lisberg/cable_tester2/hardware/sim/report.md

# Channel cell simulation – Rs = 4700 Ω, Rbias = 680000 Ω

Generated by `hardware/sim/channel_sim.py` (ngspice). Worst‑case corners: Rs +1 %, Rbias −1 %, leakage 1 µA/node against the drive, mux Ron 20 Ω/stage, driver 50 Ω + Rlim 150 Ω, cable 500 pF + node 50 pF per member.

## 1. Static level on the weakest net member vs. net size

Pass criterion: ≥ 0.75·VDD (VIH(max) 0.70·VDD + 0.05·VDD margin). Typical 74HC switching point ≈ 0.5·VDD. Low polarity mirrors high polarity, so only high is shown.

| N members | VDD 4.40 V: V (ratio) | VDD 5.25 V: V (ratio) | worst case | typical (0.5·VDD) |
|---|---|---|---|---|
| 1 | 4.33 V (0.98) | 5.16 V (0.98) | PASS | PASS |
| 2 | 4.29 V (0.97) | 5.12 V (0.98) | PASS | PASS |
| 4 | 4.22 V (0.96) | 5.04 V (0.96) | PASS | PASS |
| 8 | 4.08 V (0.93) | 4.88 V (0.93) | PASS | PASS |
| 16 | 3.83 V (0.87) | 4.59 V (0.87) | PASS | PASS |
| 24 | 3.61 V (0.82) | 4.32 V (0.82) | PASS | PASS |
| 32 | 3.40 V (0.77) | 4.09 V (0.78) | PASS | PASS |
| 40 | 3.22 V (0.73) | 3.87 V (0.74) | fail | PASS |
| 48 | 3.05 V (0.69) | 3.67 V (0.70) | fail | PASS |
| 64 | 2.75 V (0.63) | 3.32 V (0.63) | fail | PASS |
| 96 | 2.28 V (0.52) | 2.77 V (0.53) | fail | fail |
| 128 | 1.92 V (0.44) | 2.36 V (0.45) | fail | fail |

**Guaranteed net size (worst case): ≥ 32 members. Typical: ≥ 64 members.**

## 2. Isolated node offset (leakage)

* VDD 4.4 V: isolated node sits at 0.687 V; VIL(min) = 0.30·VDD = 1.32 V → PASS (margin 0.63 V)
* VDD 5.25 V: isolated node sits at 0.687 V; VIL(min) = 0.30·VDD = 1.57 V → PASS (margin 0.89 V)

## 3. Settle time after the stimulus switches (5 m cable)

Time from drive edge until the weakest member crosses 0.75·VDD (VDD 4.4 V). Firmware settle time per step must exceed this. Releasing a net uses active discharge, which is the same RC path.

| N members | settle |
|---|---|
| 1 | 7.8 µs |
| 2 | 11.8 µs |
| 4 | 20.3 µs |
| 8 | 38.6 µs |
| 16 | 82.9 µs |
| 32 | 258.1 µs |
| 36 | 480.5 µs |

## 4. DC fault on a fixture node (powered, VDD5 held by the shunt clamp at 5.45 V)

| EXT | I(Rs) | P(Rs) | node voltage | share into IC ESD diodes |
|---|---|---|---|---|
| +24 V | 3.81 mA | 68 mW | 6.25 V | 3.67 mA |
| +30 V | 5.10 mA | 121 mW | 6.29 V | 4.77 mA |
| -24 V | -4.98 mA | 115 mW | -0.84 V | 4.67 mA |
| -30 V | -6.26 mA | 182 mW | -0.87 V | 5.64 mA |

Rs (1206, ≥ 0.25 W) covers the dissipation. A high‑Vf low‑leakage external clamp does **not** take the current away from the IC input diodes: most of it flows through the ICs. The bound is therefore Rs itself. Keep the per‑input injection below the IC absolute‑maximum clamp current (74HC: ±20 mA; TMUX1308: check datasheet), and make the VDD5 shunt clamp absorb the sum.

## 5. Sensitivity: Rs / Rbias / leakage

Guaranteed net size (worst case), isolated‑node offset at 4.4 V (limit 0.25·VDD = 1.10 V), and Rs dissipation at −30 V.

| Rs | Rbias | leakage/node | N guaranteed | V isolated | P(Rs) @ −30 V |
|---|---|---|---|---|---|
| 4.7 kΩ | 470 kΩ | 2 µA | 20 | 0.95 V | 182 mW |
| 4.7 kΩ | 470 kΩ | 0.5 µA | 28 | 0.24 V | 182 mW |
| 4.7 kΩ | 680 kΩ | 1 µA | 36 | 0.69 V | 182 mW ◀ chosen |
| 4.7 kΩ | 1000 kΩ | 0.5 µA | 56 | 0.51 V | 182 mW |
| 3.3 kΩ | 680 kΩ | 1 µA | 48 | 0.69 V | 259 mW ✗ |
| 3.3 kΩ | 1000 kΩ | 0.5 µA | 76 | 0.51 V | 259 mW ✗ |
| 2.2 kΩ | 1000 kΩ | 0.5 µA | 112 | 0.51 V | 387 mW ✗ |
