lisberg/cable_tester2/hardware/proto40/control.kicad_sch

## KiCad design hardware/proto40/control.kicad_sch (2026-10-07, an earlier design)

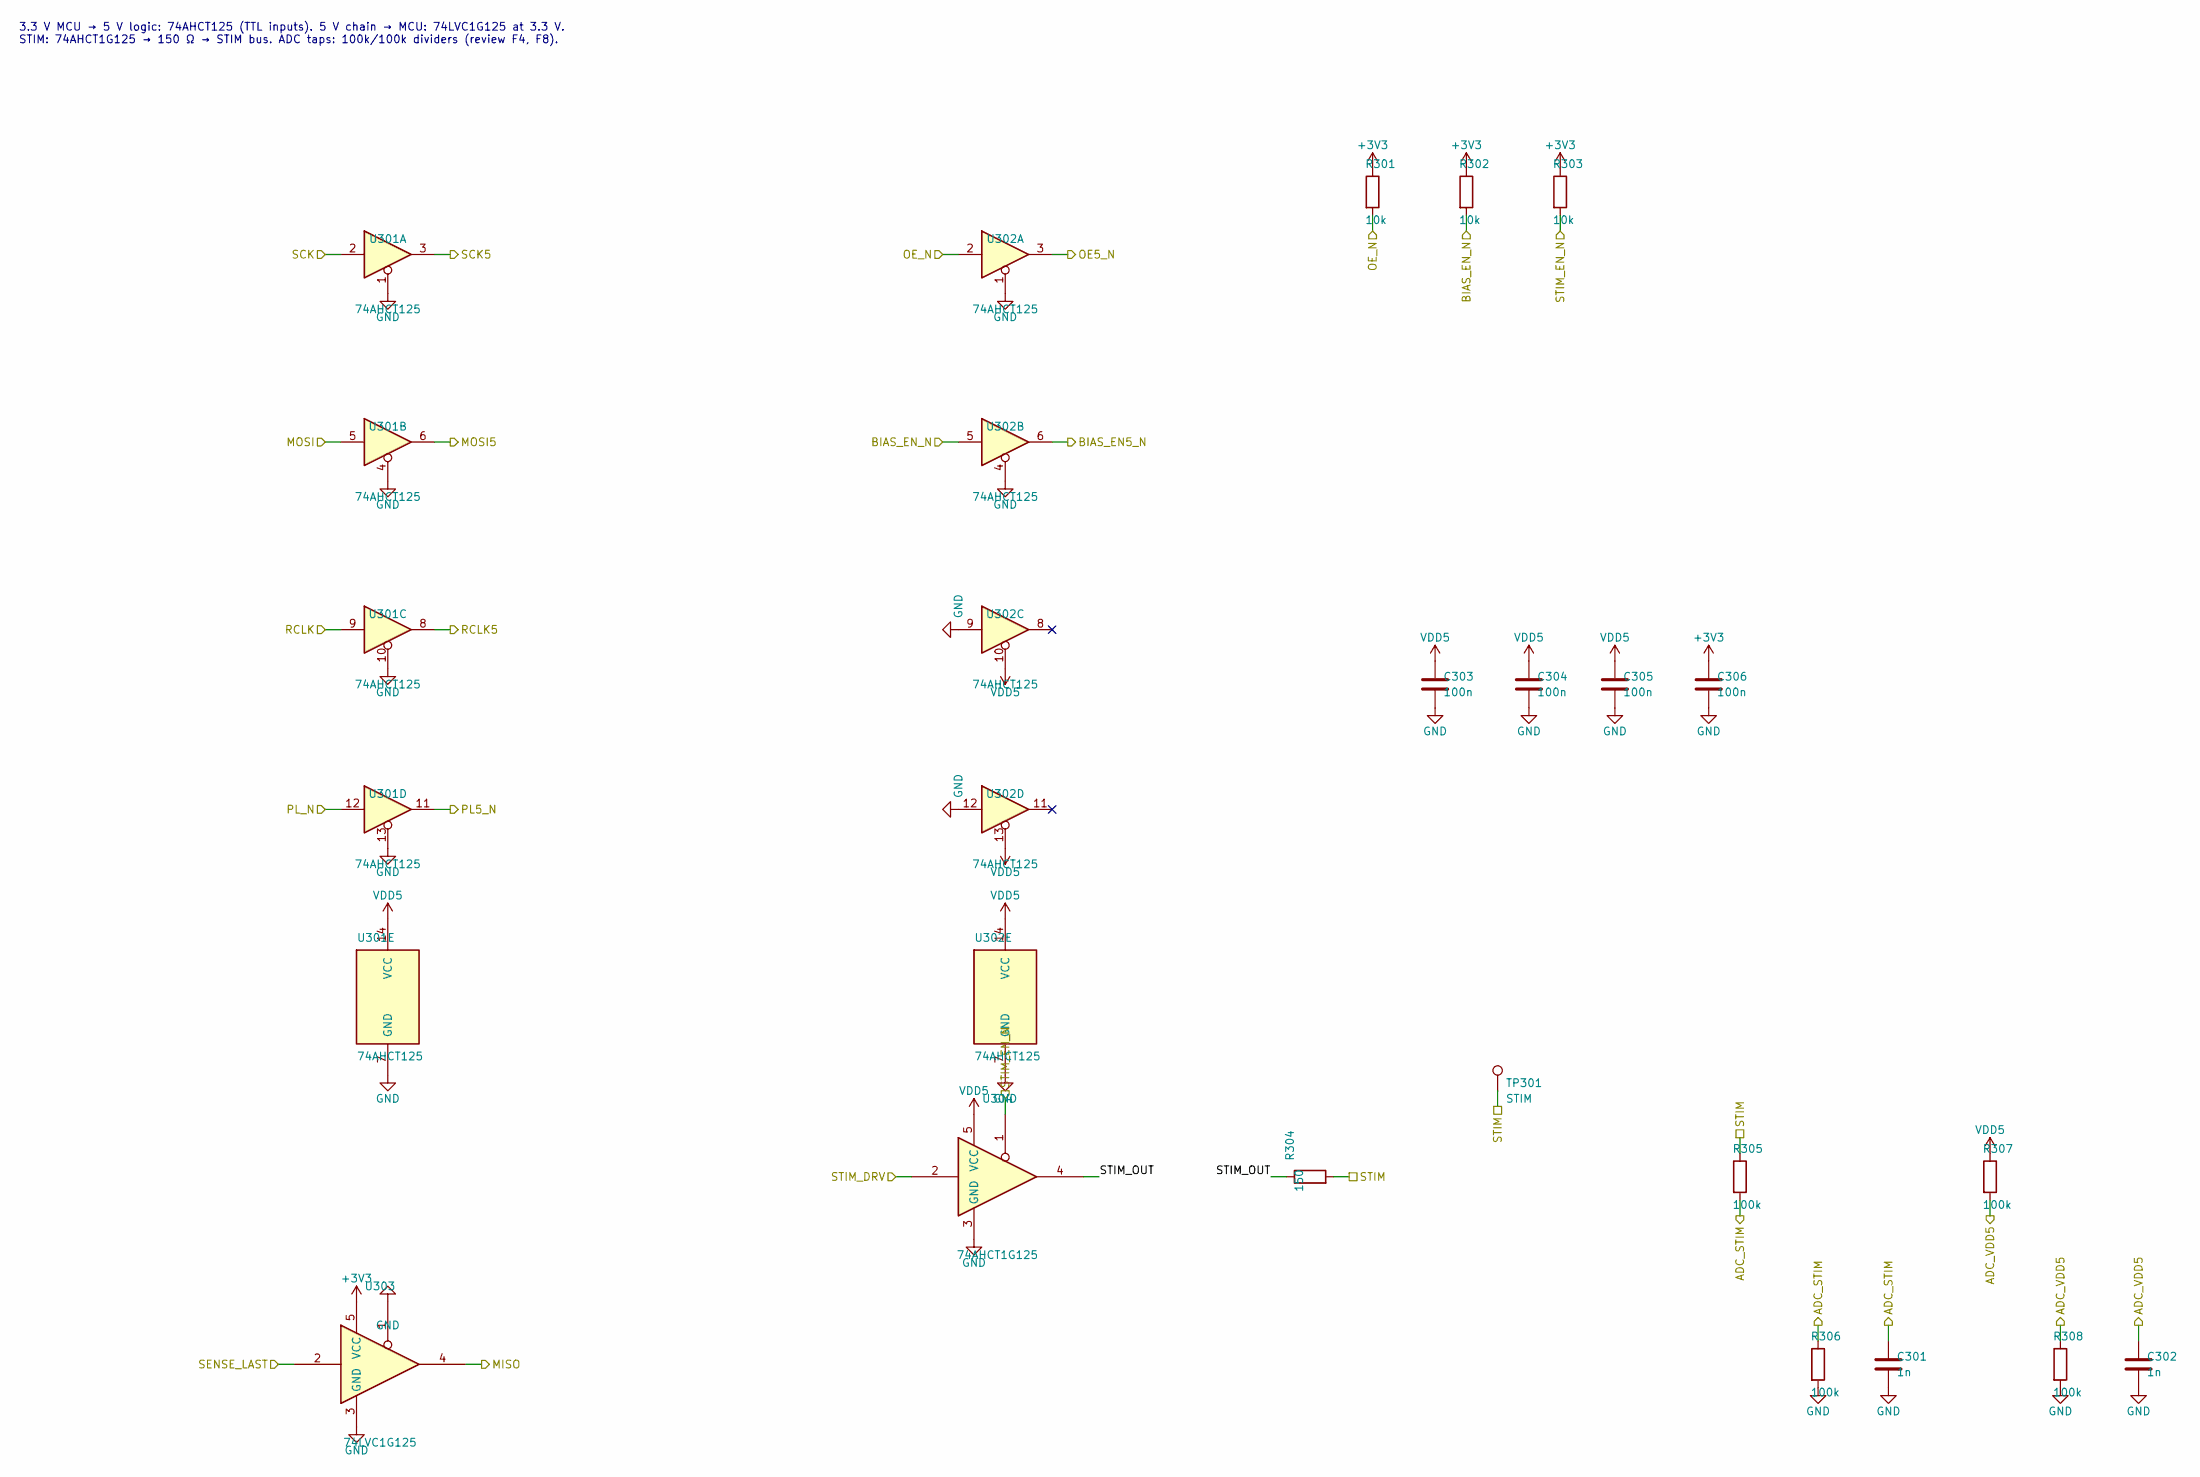
[picture p1: schematic control.kicad_sch]

Parts:
C301, C302: 1n; C_0603_1608Metric
C303, C304, C305, C306: 100n; C_0603_1608Metric
R301, R302, R303: 10k; R_0603_1608Metric
R304: 150; R_0603_1608Metric
R305, R306, R307, R308: 100k; R_0603_1608Metric
TP301: STIM; TestPoint_Pad_D1.0mm
U301, U302: 74AHCT125; TSSOP-14_4.4x5mm_P0.65mm; MPN SN74AHCT125PWR
U303: 74LVC1G125; SOT-23-5; MPN SN74LVC1G125DBVR
U304: 74AHCT1G125; SOT-23-5; MPN SN74AHCT1G125DBVR

Connections:
+3V3: C306.1, R301.1, R302.1, R303.1, U303.5 (VCC)
ADC_STIM: C301.1, R305.2, R306.1
ADC_VDD5: C302.1, R307.2, R308.1
BIAS_EN5_N: U302.6
BIAS_EN_N: R302.2, U302.5
GND: C301.2, C302.2, C303.2, C304.2, C305.2, C306.2, R306.2, R308.2, U301.1, U301.4, U301.7 (GND), U301.10, U301.13, U302.1, U302.4, U302.7 (GND), U302.9, U302.12, U303.1, U303.3 (GND), U304.3 (GND)
MISO: U303.4
MOSI: U301.5
MOSI5: U301.6
OE5_N: U302.3
OE_N: R301.2, U302.2
PL5_N: U301.11
PL_N: U301.12
RCLK: U301.9
RCLK5: U301.8
SCK: U301.2
SCK5: U301.3
SENSE_LAST: U303.2
STIM: R304.2, R305.1, TP301.1
STIM_DRV: U304.2
STIM_EN_N: R303.2, U304.1
STIM_OUT: R304.1, U304.4
VDD5: C303.1, C304.1, C305.1, R307.1, U301.14 (VCC), U302.10, U302.13, U302.14 (VCC), U304.5 (VCC)

Notes on the sheet:
3.3 V MCU → 5 V logic: 74AHCT125 (TTL inputs). 5 V chain → MCU: 74LVC1G125 at 3.3 V. STIM: 74AHCT1G125 → 150 Ω → STIM bus. ADC taps: 100k/100k dividers (review F4, F8).
