lisberg/cable_tester2/hardware/proto40/group8.kicad_sch

## KiCad design hardware/proto40/group8.kicad_sch (2026-10-07, an earlier design)

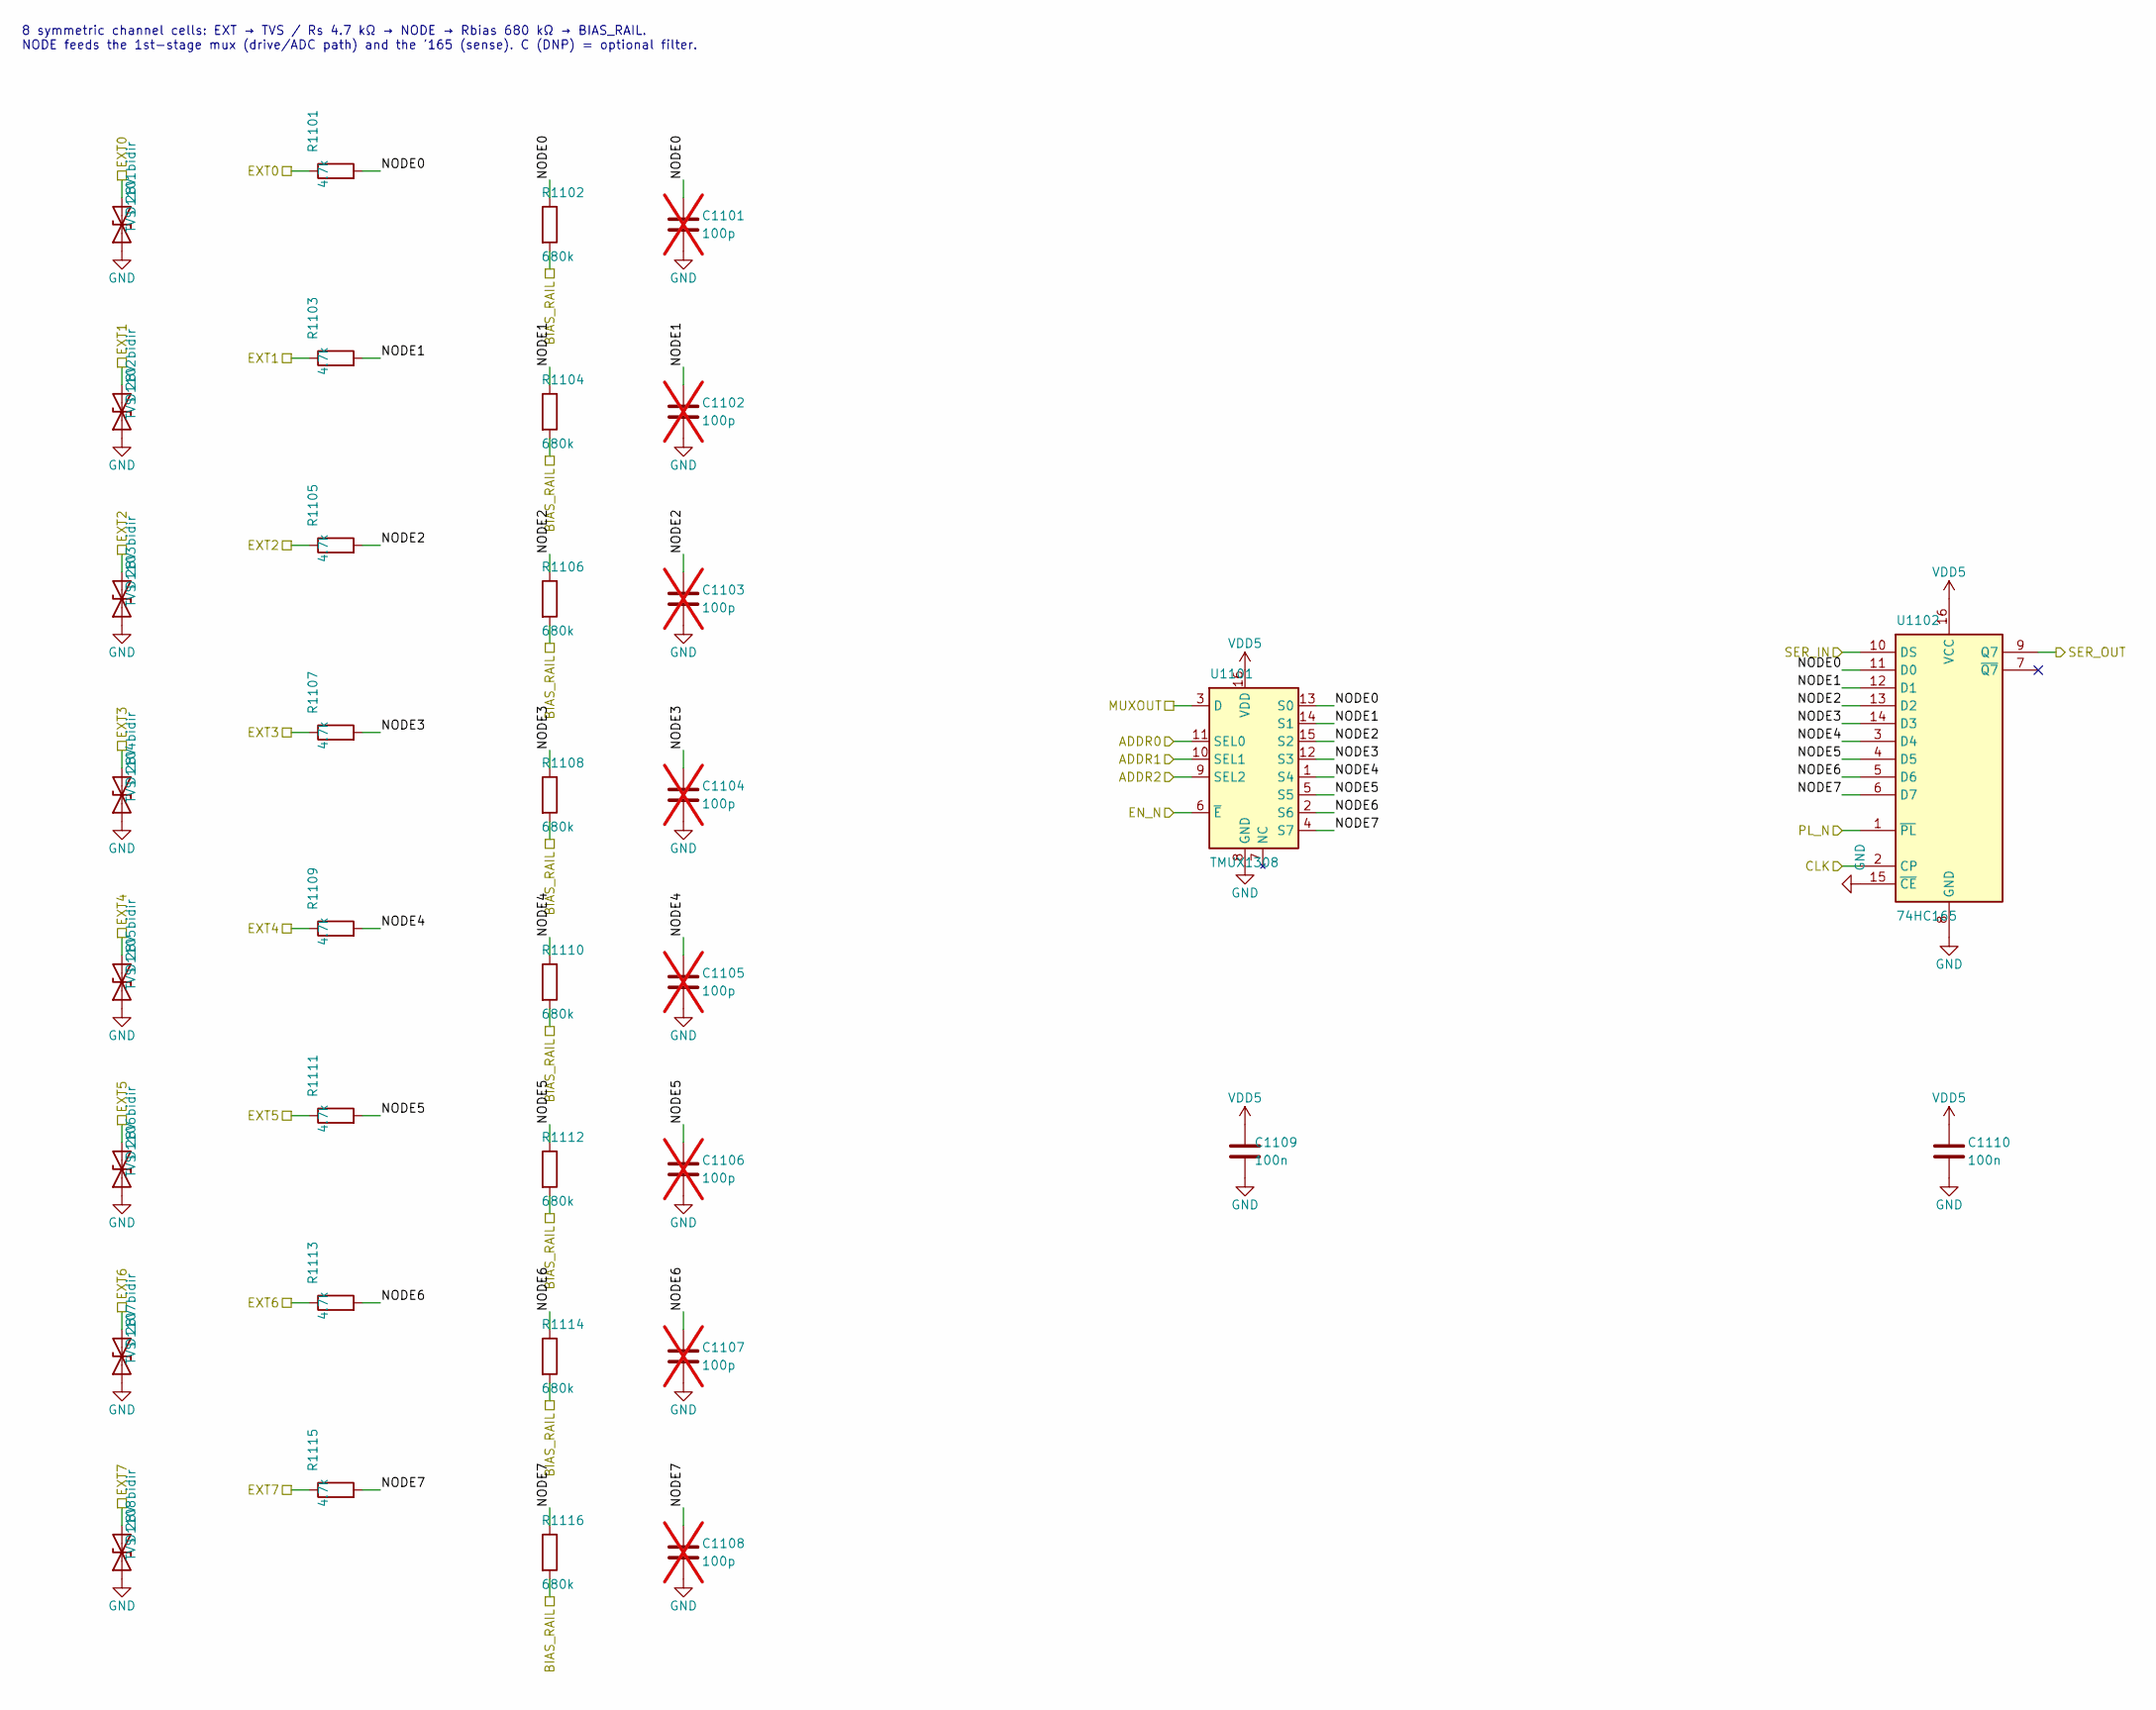
[picture p2: schematic group8.kicad_sch]

Parts:
C1101, C1102, C1103, C1104, C1105, C1106, C1107, C1108: 100p; C_0603_1608Metric; not fitted
C1109, C1110: 100n; C_0603_1608Metric
D1101, D1102, D1103, D1104, D1105, D1106, D1107, D1108: TVS 28V bidir; D_SOD-323; MPN TBD: bidirectional, VRWM >= 28 V, IR <=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
R1101, R1103, R1105, R1107, R1109, R1111, R1113, R1115: 4.7k; R_1206_3216Metric; MPN 1206 4.7 kΩ 1 % 0.25 W
R1102, R1104, R1106, R1108, R1110, R1112, R1114, R1116: 680k; R_0603_1608Metric; MPN 0603 680 kΩ 1 %
U1101: TMUX1308; TSSOP-16_4.4x5mm_P0.65mm
U1102: 74HC165; TSSOP-16_4.4x5mm_P0.65mm; MPN SN74HC165PWR

Connections:
ADDR0: U1101.11 (SEL0)
ADDR1: U1101.10 (SEL1)
ADDR2: U1101.9 (SEL2)
BIAS_RAIL: R1102.2, R1104.2, R1106.2, R1108.2, R1110.2, R1112.2, R1114.2, R1116.2
CLK: U1102.2 (CP)
EN_N: U1101.6 (~E)
EXT0: D1101.2 (A2), R1101.1
EXT1: D1102.2 (A2), R1103.1
EXT2: D1103.2 (A2), R1105.1
EXT3: D1104.2 (A2), R1107.1
EXT4: D1105.2 (A2), R1109.1
EXT5: D1106.2 (A2), R1111.1
EXT6: D1107.2 (A2), R1113.1
EXT7: D1108.2 (A2), R1115.1
GND: C1101.2, C1102.2, C1103.2, C1104.2, C1105.2, C1106.2, C1107.2, C1108.2, C1109.2, C1110.2, D1101.1 (A1), D1102.1 (A1), D1103.1 (A1), D1104.1 (A1), D1105.1 (A1), D1106.1 (A1), D1107.1 (A1), D1108.1 (A1), U1101.8 (GND), U1102.8 (GND), U1102.15 (~CE)
MUXOUT: U1101.3 (D)
NODE0: C1101.1, R1101.2, R1102.1, U1101.13 (S0), U1102.11 (D0)
NODE1: C1102.1, R1103.2, R1104.1, U1101.14 (S1), U1102.12 (D1)
NODE2: C1103.1, R1105.2, R1106.1, U1101.15 (S2), U1102.13 (D2)
NODE3: C1104.1, R1107.2, R1108.1, U1101.12 (S3), U1102.14 (D3)
NODE4: C1105.1, R1109.2, R1110.1, U1101.1 (S4), U1102.3 (D4)
NODE5: C1106.1, R1111.2, R1112.1, U1101.5 (S5), U1102.4 (D5)
NODE6: C1107.1, R1113.2, R1114.1, U1101.2 (S6), U1102.5 (D6)
NODE7: C1108.1, R1115.2, R1116.1, U1101.4 (S7), U1102.6 (D7)
PL_N: U1102.1 (~PL)
SER_IN: U1102.10 (DS)
SER_OUT: U1102.9 (Q7)
VDD5: C1109.1, C1110.1, U1101.16 (VDD), U1102.16 (VCC)

Notes on the sheet:
8 symmetric channel cells: EXT → TVS / Rs 4.7 kΩ → NODE → Rbias 680 kΩ → BIAS_RAIL. NODE feeds the 1st-stage mux (drive/ADC path) and the '165 (sense). C (DNP) = optional filter.
