lisberg/cable_tester2/hardware/proto40/mcu.kicad_sch

## KiCad design hardware/proto40/mcu.kicad_sch (2026-10-07, an earlier design)

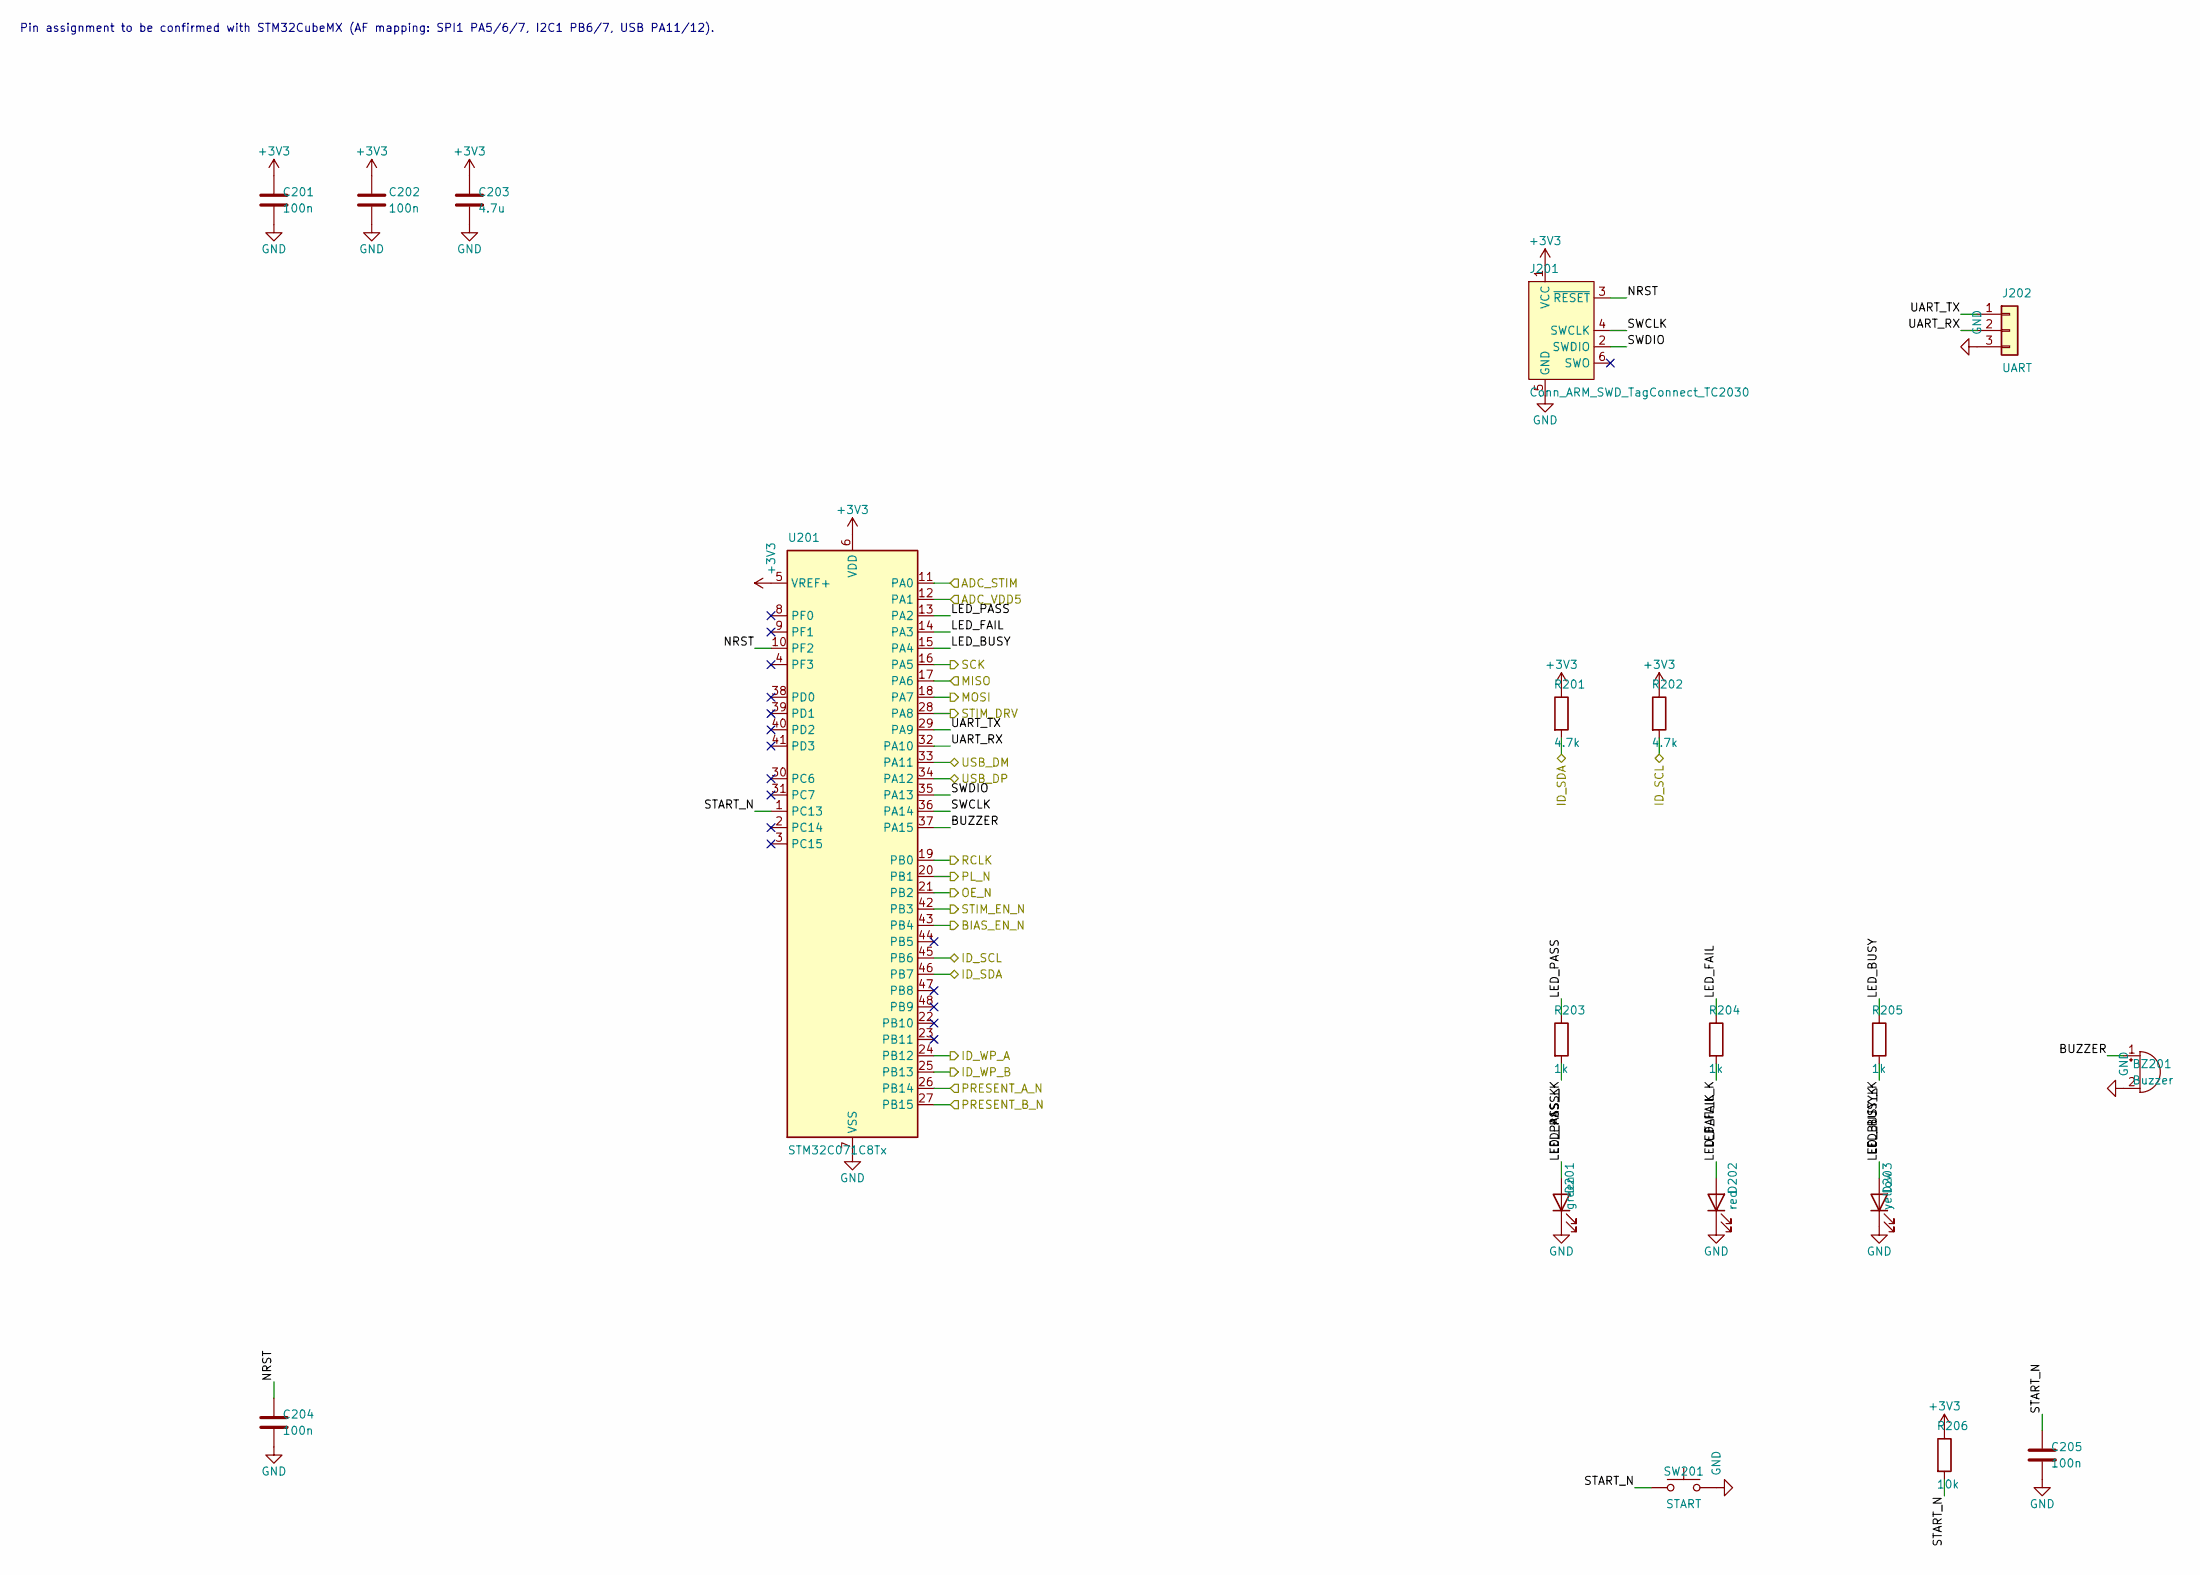
[picture p3: schematic mcu.kicad_sch]

Parts:
BZ201: Buzzer; Buzzer_12x9.5RM7.6
C201, C202, C204, C205: 100n; C_0603_1608Metric
C203: 4.7u; C_0805_2012Metric
D201: green; LED_0603_1608Metric
D202: red; LED_0603_1608Metric
D203: yellow; LED_0603_1608Metric
J201: Conn_ARM_SWD_TagConnect_TC2030; Tag-Connect_TC2030-IDC-NL_2x03_P1.27mm_Vertical
J202: UART; PinHeader_1x03_P2.54mm_Vertical
R201, R202: 4.7k; R_0603_1608Metric
R203, R204, R205: 1k; R_0603_1608Metric
R206: 10k; R_0603_1608Metric
SW201: START; SW_SPST_TL3342
U201: STM32C071C8Tx; LQFP-48_7x7mm_P0.5mm; MPN STM32C071C8T6

Connections:
+3V3: C201.1, C202.1, C203.1, J201.1 (VCC), R201.1, R202.1, R206.1, U201.5 (VREF+), U201.6 (VDD)
ADC_STIM: U201.11 (PA0)
ADC_VDD5: U201.12 (PA1)
BIAS_EN_N: U201.43 (PB4)
BUZZER: BZ201.1 (+), U201.37 (PA15)
GND: BZ201.2 (-), C201.2, C202.2, C203.2, C204.2, C205.2, D201.1 (K), D202.1 (K), D203.1 (K), J201.5 (GND), J202.3, SW201.2, U201.7 (VSS)
ID_SCL: R202.2, U201.45 (PB6)
ID_SDA: R201.2, U201.46 (PB7)
ID_WP_A: U201.24 (PB12)
ID_WP_B: U201.25 (PB13)
LED_BUSY: R205.1, U201.15 (PA4)
LED_BUSY_K: D203.2 (A), R205.2
LED_FAIL: R204.1, U201.14 (PA3)
LED_FAIL_K: D202.2 (A), R204.2
LED_PASS: R203.1, U201.13 (PA2)
LED_PASS_K: D201.2 (A), R203.2
MISO: U201.17 (PA6)
MOSI: U201.18 (PA7)
NRST: C204.1, J201.3 (~RESET), U201.10 (PF2)
OE_N: U201.21 (PB2)
PL_N: U201.20 (PB1)
PRESENT_A_N: U201.26 (PB14)
PRESENT_B_N: U201.27 (PB15)
RCLK: U201.19 (PB0)
SCK: U201.16 (PA5)
START_N: C205.1, R206.2, SW201.1, U201.1 (PC13)
STIM_DRV: U201.28 (PA8)
STIM_EN_N: U201.42 (PB3)
SWCLK: J201.4 (SWCLK), U201.36 (PA14)
SWDIO: J201.2 (SWDIO), U201.35 (PA13)
UART_RX: J202.2, U201.32 (PA10)
UART_TX: J202.1, U201.29 (PA9)
USB_DM: U201.33 (PA11)
USB_DP: U201.34 (PA12)

Notes on the sheet:
Pin assignment to be confirmed with STM32CubeMX (AF mapping: SPI1 PA5/6/7, I2C1 PB6/7, USB PA11/12).
