lisberg/cable_tester2/hardware/proto40/power.kicad_sch

## KiCad design hardware/proto40/power.kicad_sch (2026-10-07, an earlier design)

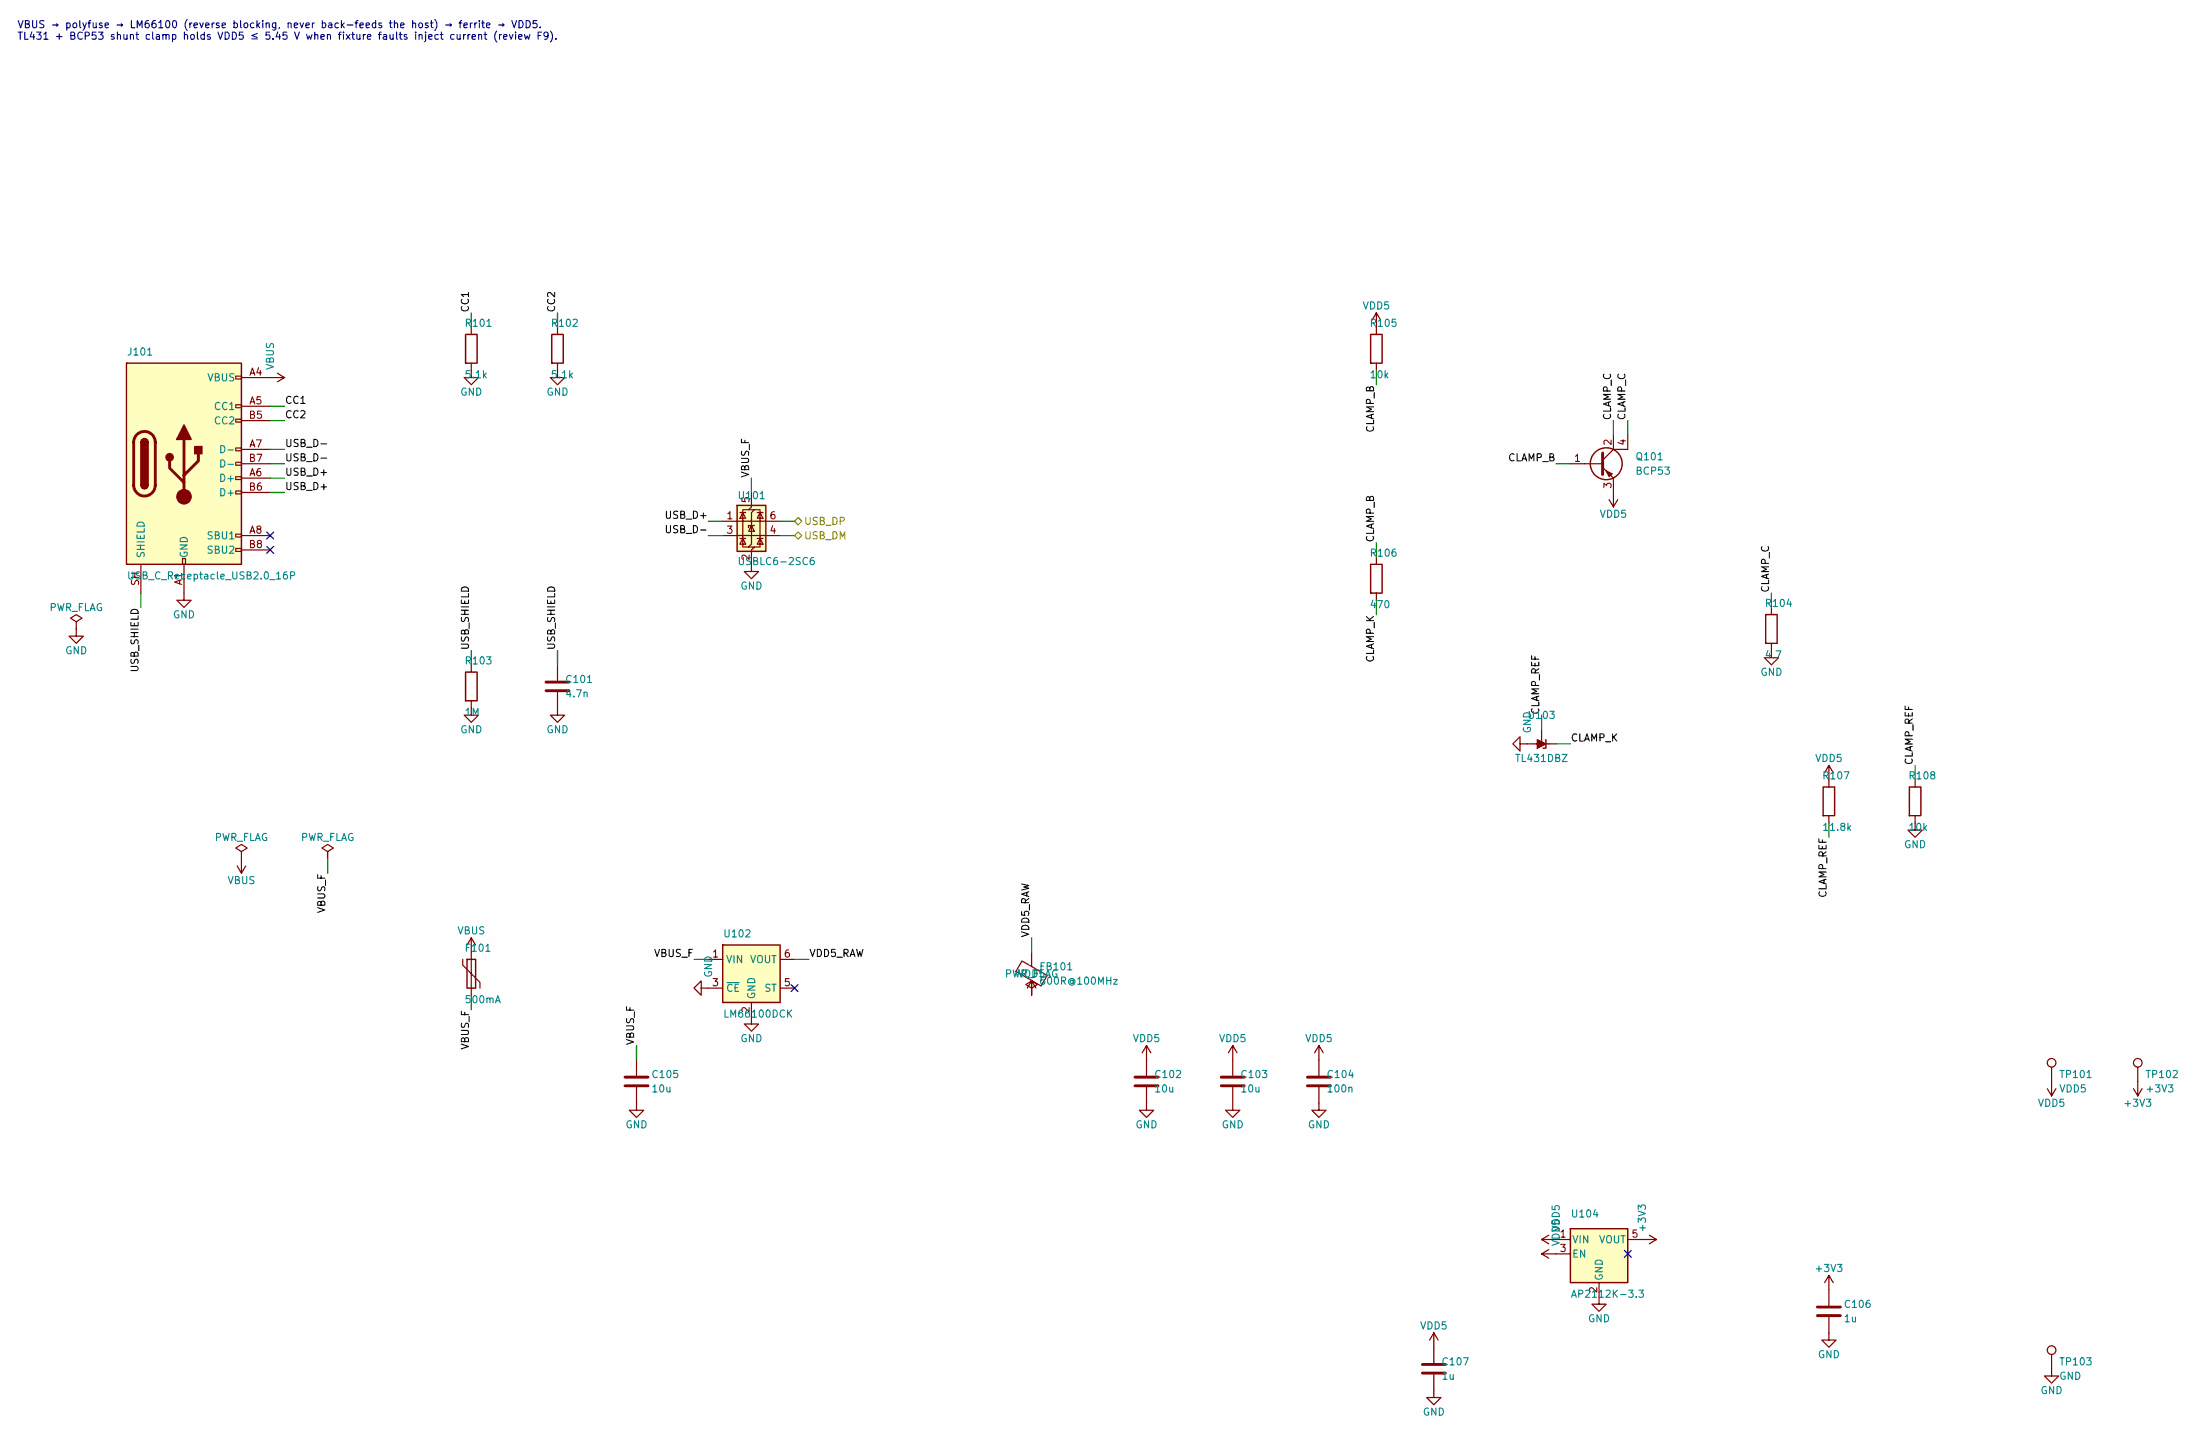
[picture p4: schematic power.kicad_sch]

Parts:
C101: 4.7n; C_0603_1608Metric
C102, C103, C105: 10u; C_0805_2012Metric
C104: 100n; C_0603_1608Metric
C106, C107: 1u; C_0603_1608Metric
F101: 500mA; Fuse_1206_3216Metric; MPN 1206 PTC 500 mA hold, 6 V
FB101: 600R@100MHz; L_0603_1608Metric
J101: USB_C_Receptacle_USB2.0_16P; USB_C_Receptacle_HCTL_HC-TYPE-C-16P-01A
Q101: BCP53; SOT-223-3_TabPin2; MPN BCP53-16
R101, R102: 5.1k; R_0603_1608Metric
R103: 1M; R_0603_1608Metric
R104: 4.7; R_1206_3216Metric
R105, R108: 10k; R_0603_1608Metric
R106: 470; R_0603_1608Metric
R107: 11.8k; R_0603_1608Metric
TP101: VDD5; TestPoint_Pad_D1.0mm
TP102: +3V3; TestPoint_Pad_D1.0mm
TP103: GND; TestPoint_Pad_D1.0mm
U101: USBLC6-2SC6; SOT-23-6; MPN USBLC6-2SC6
U102: LM66100DCK; SOT-363_SC-70-6; MPN LM66100DCKR
U103: TL431DBZ; SOT-23; MPN TL431BIDBZR
U104: AP2112K-3.3; SOT-23-5; MPN AP2112K-3.3TRG1

Connections:
+3V3: C106.1, TP102.1, U104.5 (VOUT)
CC1: J101.A5 (CC1), R101.1
CC2: J101.B5 (CC2), R102.1
CLAMP_B: Q101.1 (B), R105.2, R106.1
CLAMP_C: Q101.2 (C), Q101.4 (C), R104.1
CLAMP_K: R106.2, U103.1 (K)
CLAMP_REF: R107.2, R108.1, U103.2 (REF)
GND: C101.2, C102.2, C103.2, C104.2, C105.2, C106.2, C107.2, J101.A1 (GND), J101.A12 (GND), J101.B1 (GND), J101.B12 (GND), R101.2, R102.2, R103.2, R104.2, R108.2, TP103.1, U101.2 (GND), U102.2 (GND), U102.3 (~CE), U103.3 (A), U104.2 (GND)
USB_D+: J101.A6 (D+), J101.B6 (D+), U101.1 (I/O1)
USB_D-: J101.A7 (D-), J101.B7 (D-), U101.3 (I/O2)
USB_DM: U101.4 (I/O2)
USB_DP: U101.6 (I/O1)
USB_SHIELD: C101.1, J101.SH (SHIELD), R103.1
VBUS: F101.1, J101.A4 (VBUS), J101.A9 (VBUS), J101.B4 (VBUS), J101.B9 (VBUS)
VBUS_F: C105.1, F101.2, U101.5 (VBUS), U102.1 (VIN)
VDD5: C102.1, C103.1, C104.1, C107.1, FB101.2, Q101.3 (E), R105.1, R107.1, TP101.1, U104.1 (VIN), U104.3 (EN)
VDD5_RAW: FB101.1, U102.6 (VOUT)

Notes on the sheet:
VBUS → polyfuse → LM66100 (reverse blocking, never back-feeds the host) → ferrite → VDD5. TL431 + BCP53 shunt clamp holds VDD5 ≤ 5.45 V when fixture faults inject current (review F9).
