lisberg/cable_tester2/hardware/proto40/side.kicad_sch

## KiCad design hardware/proto40/side.kicad_sch (2026-10-07, an earlier design)

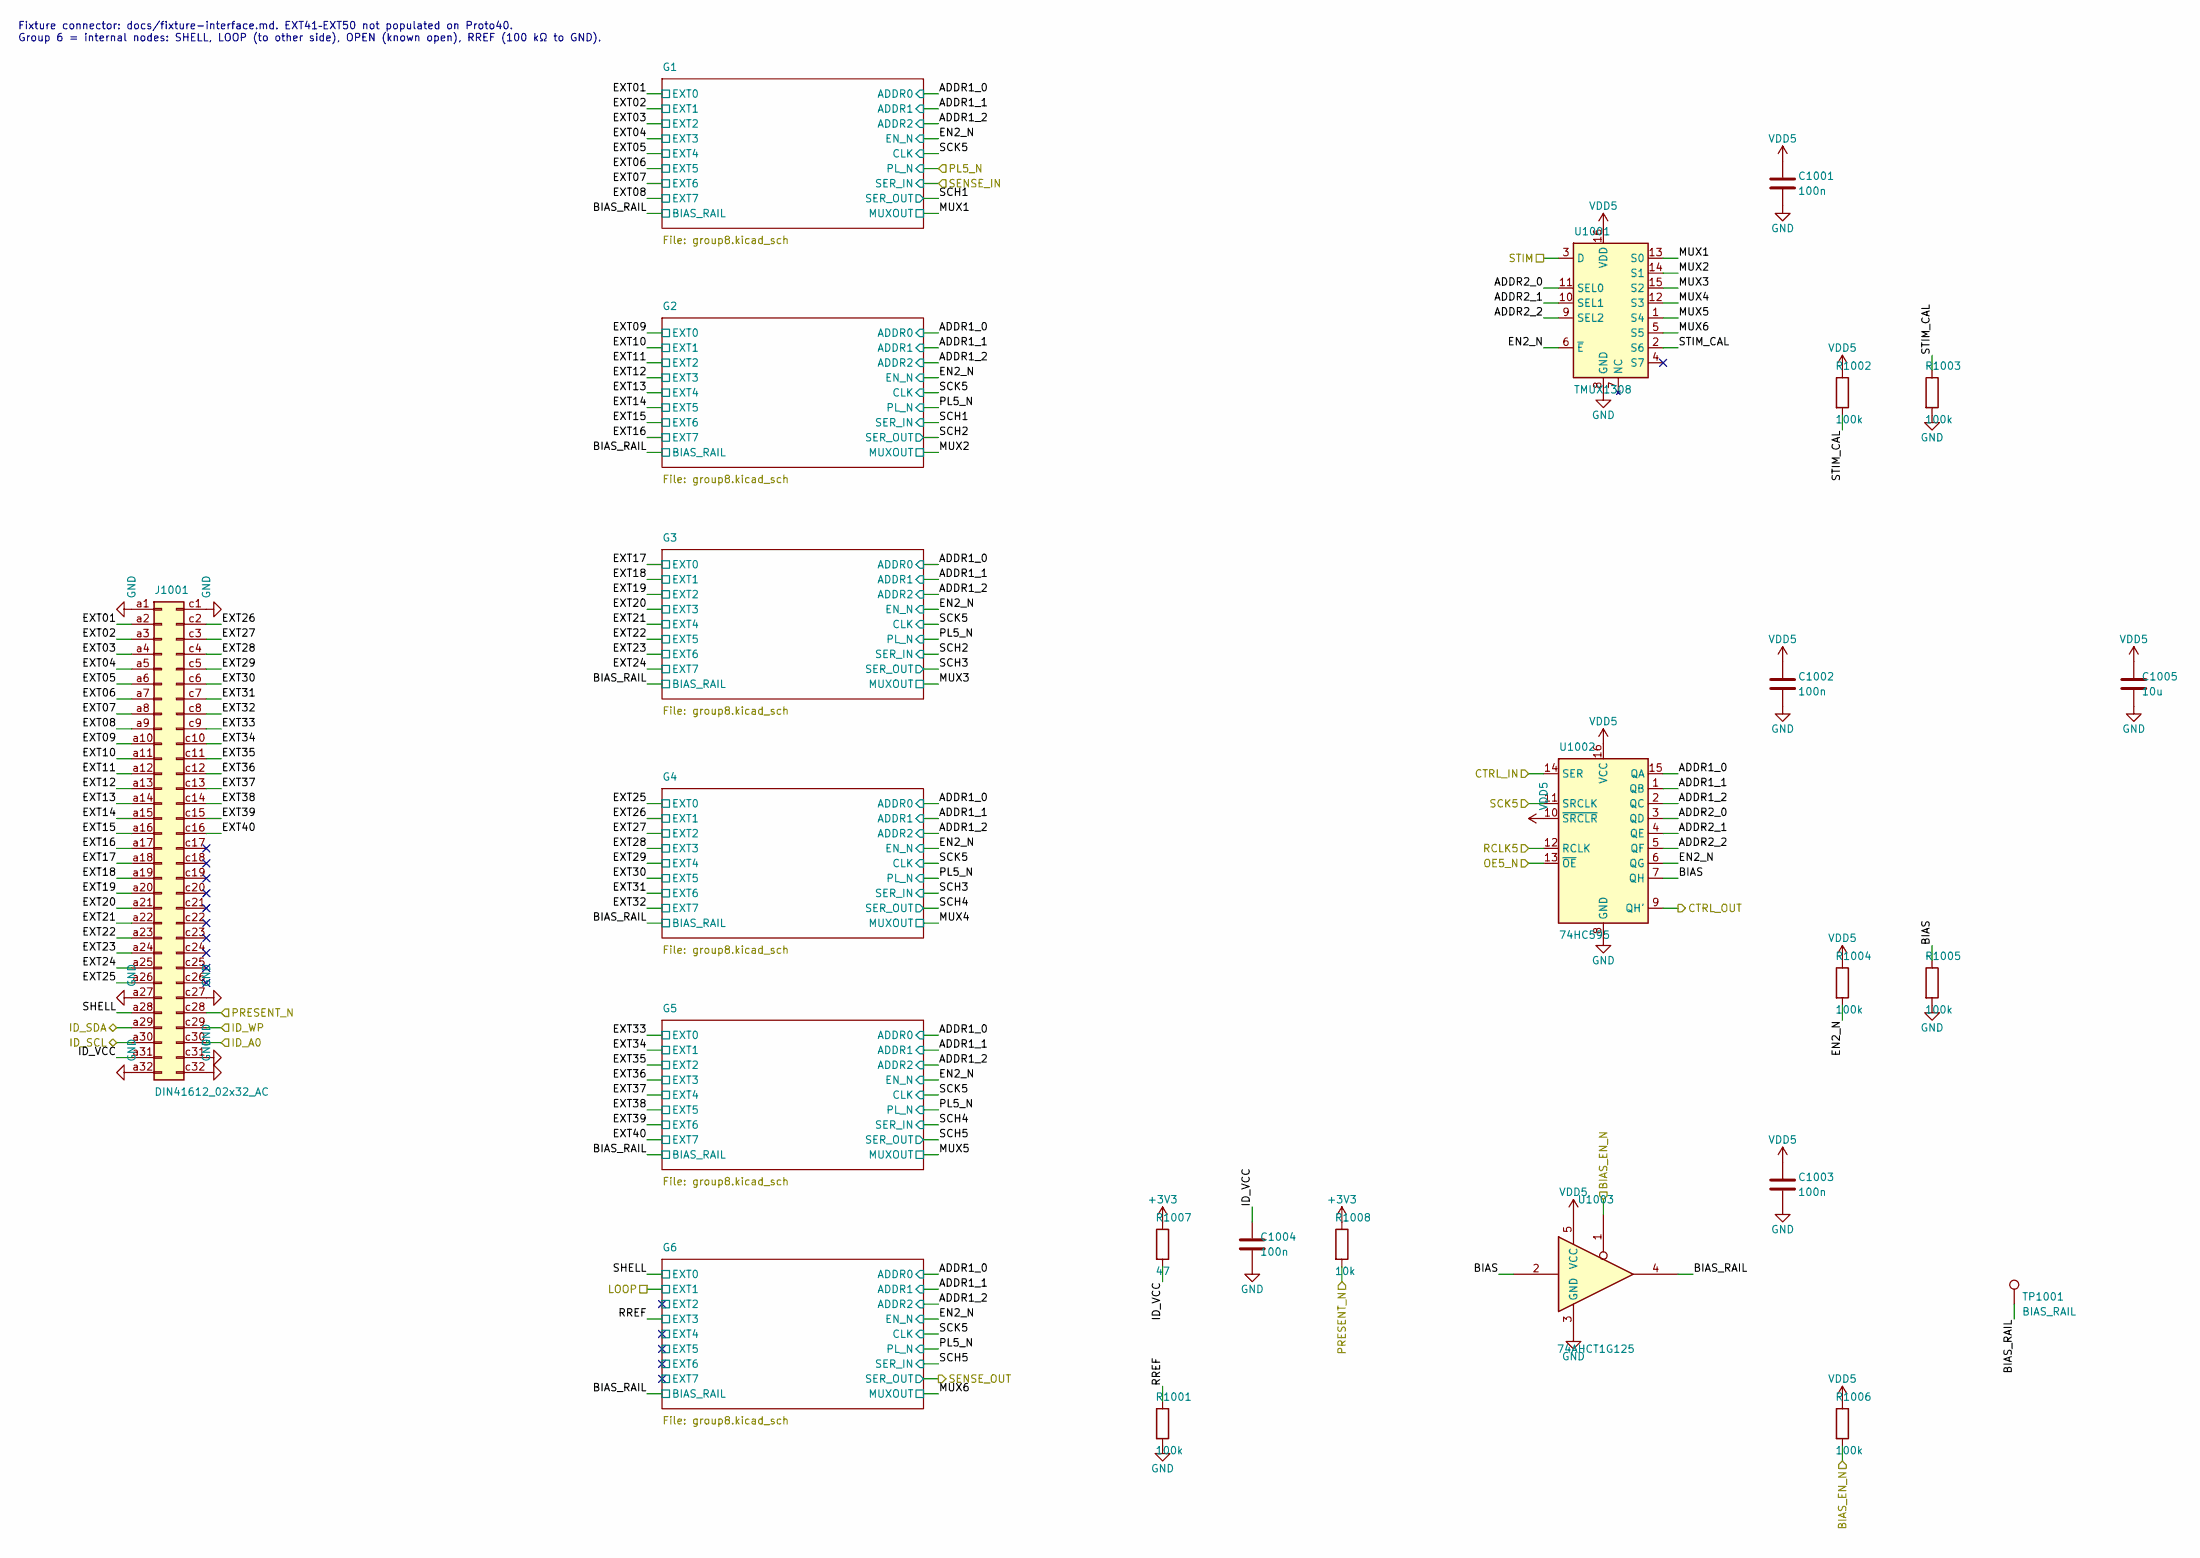
[picture p5: schematic side.kicad_sch]

Parts:
C1001, C1002, C1003, C1004: 100n; C_0603_1608Metric
C1005: 10u; C_0805_2012Metric
J1001: DIN41612_02x32_AC; DIN41612_C_2x32_Female_Vertical_THT; MPN DIN 41612 type C 2x32 female vertical, 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
R1001, R1002, R1003, R1004, R1005, R1006: 100k; R_0603_1608Metric
R1007: 47; R_0603_1608Metric
R1008: 10k; R_0603_1608Metric
TP1001: BIAS_RAIL; TestPoint_Pad_D1.0mm
U1001: TMUX1308; TSSOP-16_4.4x5mm_P0.65mm
U1002: 74HC595; TSSOP-16_4.4x5mm_P0.65mm; MPN SN74HC595PWR
U1003: 74AHCT1G125; SOT-23-5; MPN SN74AHCT1G125DBVR

Connections:
+3V3: R1007.1, R1008.1
ADDR1_0: U1002.15 (QA)
ADDR1_1: U1002.1 (QB)
ADDR1_2: U1002.2 (QC)
ADDR2_0: U1001.11 (SEL0), U1002.3 (QD)
ADDR2_1: U1001.10 (SEL1), U1002.4 (QE)
ADDR2_2: U1001.9 (SEL2), U1002.5 (QF)
BIAS: R1005.1, U1002.7 (QH), U1003.2
BIAS_EN_N: R1006.2, U1003.1
BIAS_RAIL: TP1001.1, U1003.4
CTRL_IN: U1002.14 (SER)
CTRL_OUT: U1002.9 (QH')
EN2_N: R1004.2, U1001.6 (~E), U1002.6 (QG)
EXT01: J1001.a2
EXT02: J1001.a3
EXT03: J1001.a4
EXT04: J1001.a5
EXT05: J1001.a6
EXT06: J1001.a7
EXT07: J1001.a8
EXT08: J1001.a9
EXT09: J1001.a10
EXT10: J1001.a11
EXT11: J1001.a12
EXT12: J1001.a13
EXT13: J1001.a14
EXT14: J1001.a15
EXT15: J1001.a16
EXT16: J1001.a17
EXT17: J1001.a18
EXT18: J1001.a19
EXT19: J1001.a20
EXT20: J1001.a21
EXT21: J1001.a22
EXT22: J1001.a23
EXT23: J1001.a24
EXT24: J1001.a25
EXT25: J1001.a26
EXT26: J1001.c2
EXT27: J1001.c3
EXT28: J1001.c4
EXT29: J1001.c5
EXT30: J1001.c6
EXT31: J1001.c7
EXT32: J1001.c8
EXT33: J1001.c9
EXT34: J1001.c10
EXT35: J1001.c11
EXT36: J1001.c12
EXT37: J1001.c13
EXT38: J1001.c14
EXT39: J1001.c15
EXT40: J1001.c16
GND: C1001.2, C1002.2, C1003.2, C1004.2, C1005.2, J1001.a1, J1001.a27, J1001.a32, J1001.c1, J1001.c27, J1001.c31, J1001.c32, R1001.2, R1003.2, R1005.2, U1001.8 (GND), U1002.8 (GND), U1003.3 (GND)
ID_A0: J1001.c30
ID_SCL: J1001.a30
ID_SDA: J1001.a29
ID_VCC: C1004.1, J1001.a31, R1007.2
ID_WP: J1001.c29
MUX1: U1001.13 (S0)
MUX2: U1001.14 (S1)
MUX3: U1001.15 (S2)
MUX4: U1001.12 (S3)
MUX5: U1001.1 (S4)
MUX6: U1001.5 (S5)
OE5_N: U1002.13 (~OE)
PRESENT_N: J1001.c28, R1008.2
RCLK5: U1002.12 (RCLK)
RREF: R1001.1
SCK5: U1002.11 (SRCLK)
SHELL: J1001.a28
STIM: U1001.3 (D)
STIM_CAL: R1002.2, R1003.1, U1001.2 (S6)
VDD5: C1001.1, C1002.1, C1003.1, C1005.1, R1002.1, R1004.1, R1006.1, U1001.16 (VDD), U1002.10 (~SRCLR), U1002.16 (VCC), U1003.5 (VCC)

Notes on the sheet:
Fixture connector: docs/fixture-interface.md. EXT41–EXT50 not populated on Proto40. Group 6 = internal nodes: SHELL, LOOP (to other side), OPEN (known open), RREF (100 kΩ to GND).
