lisberg/cable_tester2/hardware/gen/sexpr.py

"""Minimal S-expression reader/writer for KiCad files."""
import re

_TOK = re.compile(r'\s*(?:(\()|(\))|"((?:[^"\\]|\\.)*)"|([^\s()"]+))', re.S)

class Q(str):
    """A quoted string atom."""

def parse(text):
    stack, cur = [], []
    pos = 0
    n = len(text)
    while pos < n:
        m = _TOK.match(text, pos)
        if not m:
            if text[pos:].strip() == "":
                break
            raise ValueError(f"parse error at {pos}: {text[pos:pos+40]!r}")
        pos = m.end()
        if m.group(1):
            stack.append(cur); cur = []
        elif m.group(2):
            done = cur; cur = stack.pop(); cur.append(done)
        elif m.group(3) is not None:
            cur.append(Q(m.group(3).replace('\\"', '"').replace("\\\\", "\\")))
        else:
            cur.append(m.group(4))
    return cur[0] if len(cur) == 1 else cur

def dump(x, indent=0):
    if isinstance(x, list):
        if not x:
            return "()"
        simple = all(not isinstance(e, list) for e in x)
        if simple:
            return "(" + " ".join(dump(e) for e in x) + ")"
        pad = "\t" * (indent + 1)
        parts = []
        head = []
        for e in x:
            if isinstance(e, list):
                break
            head.append(dump(e))
        rest = x[len(head):]
        s = "(" + " ".join(head)
        for e in rest:
            s += "\n" + pad + dump(e, indent + 1)
        return s + "\n" + "\t" * indent + ")"
    if isinstance(x, Q):
        return '"' + x.replace("\\", "\\\\").replace('"', '\\"').replace("\n", "\\n") + '"'
    if isinstance(x, float):
        return f"{x:.4f}".rstrip("0").rstrip(".") if x != int(x) else str(int(x))
    return str(x)

def find(node, key):
    return [e for e in node if isinstance(e, list) and e and e[0] == key]

def first(node, key):
    r = find(node, key)
    return r[0] if r else None
