lisberg/cable_tester2/(commit log)

2026-10-01 Add design review and KiCad realization plan for cable tester
    Claude-Session: https://claude.ai/code/session_01UG7pR5ZtgvoVGRWFojzQKf
2026-10-01 Record decisions, add KiCad 10 infrastructure and first adapter data
    - Decision log: symmetric cells, 5 V domain, +-24 V fault rating, JLCPCB,
    KiCad 10 (CI pinned 10.0.6), checks on pull requests, ADP-0001
    - Review updated for 5 V / +-24 V: Rs 4.7k, Rbias 470k, clamp chain,
    VDD5 shunt clamp, 32-node guaranteed net size; prototype -> Proto40
    - hardware/_template: JLC04161H-7628 stack-up, JLCPCB rules, net classes,
    custom clearance rules (verified to trigger), title block variables
    - hardware/proto40 skeleton, project library, lib tables
    - scripts: ERC/DRC check, PDF/BOM/fab outputs, new board from template
    - GitHub Actions: kicad-cli checks on pull requests, fab outputs on hw/* tags
    - f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
    [C1_tap_ribbon_to_m12f.nets.csv, C2_m12m_to_fluidic.nets.csv, C3_chain_c1_c2.nets.csv, _template.kicad_pcb, _template.kicad_sch, adapter_pinmap.csv, proto40.kicad_pcb, proto40.kicad_sch]
2026-10-06 Lock analog values by simulation, freeze fixture interface, update ADP-0001
    - hardware/sim: ngspice channel-cell model (net size, leakage offset,
    settle time, +-24/30 V fault currents, Rs/Rbias/leakage sensitivity)
    -> Rs 4.7k, Rbias 680k, leakage <= 1 uA/node, 32-node nets guaranteed
    - Correct F9: low-leakage clamps do not divert fault current from IC
    input diodes; Rs is the limiter, external clamps become DNP option
    - docs/fixture-interface.md: DIN 41612 C 2x32 pinout (50 nodes, shell,
    ID bus, WP, A0 strap, presence, 7 GND)
    - Decisions D2, D4, D7, D11, D13 recorded
    - ADP-0001: C2 GND wires commoned into one net; C3 regenerated with new
    scripts/chain_nets.py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
    [C2_m12m_to_fluidic.nets.csv, C3_chain_c1_c2.nets.csv]
2026-10-06 Generate Proto40 schematic; add generator, project library and CI checks
    - hardware/gen: KiCad 10 schematic generator (library import with extends
    flattening, label/power connections on pin ends, multi-instance
    hierarchical sheets, per-instance references, deterministic UUIDs)
    - hardware/lib: VDD5 power symbol, TMUX1308 (4051-compatible pinout,
    flagged for datasheet verification)
    - hardware/proto40: root, power (USB-C, LM66100, VDD5 shunt clamp,
    3.3 V), MCU (STM32C071, SWD, UART, UI), control (level shifting, STIM
    driver, ADC taps), 2 x side (DIN 41612 C 2x32, 6 groups, 2nd-stage
    mux, 595, bias driver, ID bus), 12 x group8 (channel cells, mux, 165)
    - ERC: 0 violations at all seve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
    [control.kicad_sch, group8.kicad_sch, mcu.kicad_sch, power.kicad_sch, proto40.kicad_sch, side.kicad_sch]
2026-10-06 Redraw Proto40 schematic with wired functional blocks
    Review feedback: text overlapped components and parts were isolated
    islands joined only by labels, so connectivity was hard to follow.
    - Generator: polyline wires, automatic junctions, text placement from
    the real symbol body graphics, KiCad field-angle handling for rotated
    symbols, power symbols oriented normally on horizontal pins
    - Sheets redrawn left-to-right with wired blocks: channel cells, BIAS
    rail, decoupling on IC power pins, pull-ups on their lines, control
    ladder across the six groups, visible 165 chain, wired root hierarchy
    (MCU -> Control -> both sides) and cross-side LOOP
    - layoutcheck.py: rejects text/text, text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
    [control.kicad_sch, group8.kicad_sch, mcu.kicad_sch, power.kicad_sch, proto40.kicad_sch, side.kicad_sch]
2026-10-06 Fix remaining text/wire overlaps in Proto40 schematic
    - Two-terminal parts choose text side from the pin axis, not the body
    shape (caps had ref/value centred on their own pin lines)
    - Layout check now also tests text against drawn pin lines and the
    enlarged DNP cross, which it previously could not see
    - Wider spacing for cap rows (text beside each cap), left-side text for
    caps placed left of an IC, LDO text moved clear of its input cap
    ERC 0 violations, design-intent audit PASS, layout issues 0.
    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
    [control.kicad_sch, group8.kicad_sch, mcu.kicad_sch, power.kicad_sch, side.kicad_sch]
2026-10-07 Give every pin its own wire; fix label overlaps on dense pin columns
    Review feedback: parts connected directly onto wires (pull-ups, caps,
    TVS) and MCU labels partially overlapping.
    - House rule in the generator: every pin leaves through its own short
    wire; power symbols sit at the end of a stub; pull-ups, caps, TVS,
    test points and power flags tap lines via a stub and junction
    - layoutcheck: new pin/pin and pin/wire rules, realistic label heights
    (local label under hierarchical label is now detected), wires through
    power symbols
    - MCU/connector/'165: local labels on long stubs clear of adjacent
    hierarchical labels; sideways power ties where rows are dense
    - Channel cell pitch 30.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
    [control.kicad_sch, group8.kicad_sch, mcu.kicad_sch, power.kicad_sch, proto40.kicad_sch, side.kicad_sch]
2026-10-07 Add kicad-schematics skill and shared house-style module
    - .claude/skills/kicad-schematics/SKILL.md: mandatory drawing rules from
    the Proto40 review (wired blocks, rails, every pin with its own wire,
    taps with junctions, text clear of wires/pins/bodies, label spacing on
    dense pins, ASCII notes), generator usage, required checks (strict
    layout check, ERC, design-intent audit, rendered review) and a
    pre-handover checklist
    - hardware/gen/style.py: house-style helpers moved out of proto40.py so
    every new design reuses them (Proto40 output unchanged, byte-identical)
    - CLAUDE.md and hardware/gen/README.md point to the skill
    Claud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
2026-10-07 Rename skill to ecad-house-style and trigger it for all ECAD work
    - Description now covers any ECAD task (schematics, PCB layout,
    symbols/footprints, netlists, BOMs, ERC/DRC, fab outputs) in any EDA
    tool, to be loaded before starting
    - New section on PCB layout, libraries and outputs (template rules,
    multichannel replication, protection placement, DRC before outputs,
    other EDA tools)
    - CLAUDE.md: load ecad-house-style before any ECAD work
    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
